mattgardner70/best-ball-balancer/images/driver_wall.png

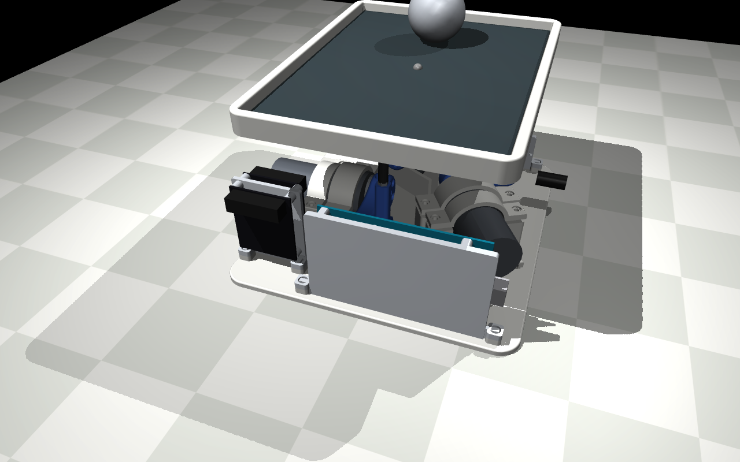
images/driver_wall.png
