mattgardner70/best-ball-balancer/images/hero.png

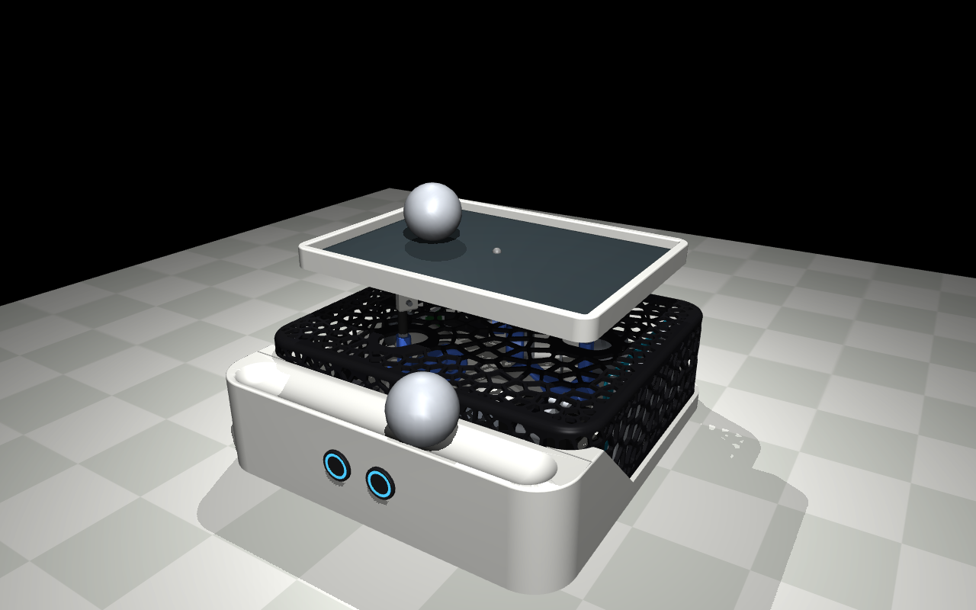
images/hero.png
