mattgardner70/best-ball-balancer/images/hero_liner.png

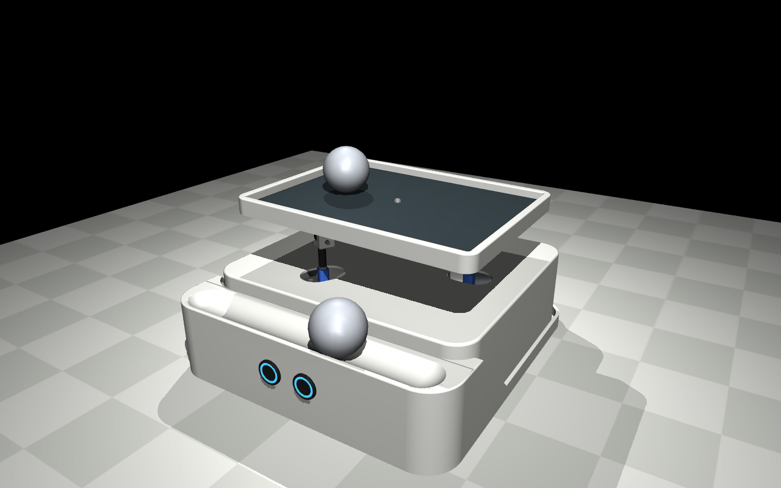
images/hero_liner.png
