mattgardner70/best-ball-balancer/BOM/BOM.md

# Bill of materials

About **$306** in parts at the listed prices, motors and motor drivers included. Links are the listings used for this build; equivalent parts work. **Price ea** is per item, or per pack where you buy a pack; **Total** is what you pay for that line.

## Motion

| Part | Qty used | Buy | Price ea | Total | Where |
|---|---|---|---|---|---|
| GA37-520 (JGB37-520) 12 V gearmotor with hall encoder, 333 rpm | 3 | 3 | $14.40 | $43.20 | [Sileduove B0H4TS383B](https://www.amazon.com/dp/B0H4TS383B) |
| 6 mm rigid flange coupling, 22 mm flange, 4-hole | 3 | 1 pack of 4 | $6.98 | $6.98 | [Amazon B08334N261](https://www.amazon.com/dp/B08334N261) |
| Shoulder bolt, 4 × 10 mm shoulder, M3 × 6 thread (elbow pin) | 3 | 1 pack of 12 | $7.97 | $7.97 | [uxcell B0DP71MPP7](https://www.amazon.com/dp/B0DP71MPP7) |
| Flanged bronze bushing, 4 mm bore × 8 mm OD (elbow) | 3 | 1 pack of 6 | $5.99 | $5.99 | [HARFINGTON B0CGDT9YYW](https://www.amazon.com/dp/B0CGDT9YYW) |
| M3 tie-rod end, ball head (plate joints) | 3 | 1 pack of 10 | $14.09 | $14.09 | [uxcell B07QPXWDCR](https://www.amazon.com/dp/B07QPXWDCR) |
| 1.5" chrome steel ball, G25 | 2 | 1 pack of 2 | $12.95 | $12.95 | [BC Precision B007B2A4ZQ](https://www.amazon.com/dp/B007B2A4ZQ) |

## Electronics

| Part | Qty used | Buy | Price ea | Total | Where |
|---|---|---|---|---|---|
| Heatsinks, 9 × 9 × 5 mm aluminium, with 3M 8810 thermal tape | 8 | 1 pack of 20 | $6.99 | $6.99 | [Easycargo B079FQ22LK](https://www.amazon.com/dp/B079FQ22LK) |
| Arduino Mega 2560 R3 | 1 | 1 | $22.99 | $22.99 | [ELEGOO B01H4ZDYCE](https://www.amazon.com/dp/B01H4ZDYCE) |
| Cytron MDD3A dual motor driver, 4–16 V, 3 A/channel | 2 | 2 | $9.30 | $18.60 | [Cytron MDD3A](https://www.cytron.io/p-3amp-4v-16v-dc-motor-driver-2-channels) |
| USB programming cable: USB-A to **left-angle** USB-B, 2 m (the left-angle plug fits in front of the upside-down Mega; the USB-A end comes out of the console) | 1 | 1 | $8.95 | $8.95 | [StarTech USBAB2ML](https://www.amazon.com/dp/B00GOBM6OC) |
| 8.4" 4-wire resistive touch panel | 1 | 1 | $38.88 | $38.88 | [VSDISPLAY B07TZGVY8K](https://www.amazon.com/dp/B07TZGVY8K) |
| Pololu #2813 pushbutton power switch (soft power) | 1 | 1 | $8.95 | $8.95 | [pololu.com #2813](https://www.pololu.com/product/2813) |
| 12 V → 5 V buck converter, 3 A, sealed, pre-wired | 1 | 1 | $9.99 | $9.99 | [DROK B07P663XJV](https://www.amazon.com/dp/B07P663XJV) |
| POWER button: 16 mm momentary, 12 V LED ring (red), 1NO1NC | 1 | 1 | $8.99 | $8.99 | [APIELE B07GTJBR59](https://www.amazon.com/dp/B07GTJBR59) |
| MODE button: 16 mm momentary, 12 V LED ring (blue), 1NO1NC | 1 | 1 | $8.99 | $8.99 | [APIELE B07GTJ3VJJ](https://www.amazon.com/dp/B07GTJ3VJJ) |

## Power & wiring

| Part | Qty used | Buy | Price ea | Total | Where |
|---|---|---|---|---|---|
| 12 V 5 A wall adapter, 5.5 × 2.1 mm, centre + | 1 | 1 | $19.99 | $19.99 | [Chanzon B073QTNF9F](https://www.amazon.com/dp/B073QTNF9F) |
| Panel-mount 5.5 × 2.1 barrel jack, pre-wired | 1 | 1 pack of 6 | $8.99 | $8.99 | [DALQUIS B0DMW8178V](https://www.amazon.com/dp/B0DMW8178V) |
| Lever connectors (5-port × 6, 4-port × 3 used) | 8 | 1 assortment | $9.99 | $9.99 | [Amazon B0FRFM8JQC](https://www.amazon.com/dp/B0FRFM8JQC) |
| 20 AWG red/black zip cable | ~3 m | 1 spool | $7.99 | $7.99 | [EvZ B00WKHXHYW](https://www.amazon.com/dp/B00WKHXHYW) |
| Dupont jumper leads, 20 cm (M-F / F-F) | ~30 | 1 pack of 120 | $6.98 | $6.98 | [ELEGOO B01EV70C78](https://www.amazon.com/dp/B01EV70C78) |
| Small zip ties, 2.5 mm | ~20 | 1 pack | — | — | any |
| Super glue (CA) | a few drops | 1 tube | — | — | any (insert into rim) |
| Double-sided foam mounting tape | a few cm | 1 roll | — | — | any (holds the Pololu board on its plate) |

## Fasteners

| Part | Qty used | Buy | Price ea | Total | Where |
|---|---|---|---|---|---|
| M3 × 5.7 heat-set inserts | 38 | 1 pack of 100 | $9.99 | $9.99 | [ruthex B08BCRZZS3](https://www.amazon.com/dp/B08BCRZZS3) |
| M3 socket-head screw kit with nuts | see below | 1 kit | $9.99 | $9.99 | [Fgruh B0FG2BRXL3](https://www.amazon.com/dp/B0FG2BRXL3) |
| M3 × 16 grub screws (rod studs) | 3 | 1 pack of 50 | $7.89 | $7.89 | [uxcell B01AXVSM6O](https://www.amazon.com/dp/B01AXVSM6O) |

### Which screw goes where

| Fastener | Qty | Where | Step |
|---|---|---|---|
| M3 × 12 | 12 | Motor straps into the saddle inserts (2 per strap) | Mount the motors |
| M3 × 12 | 12 | Flange couplings onto the arms (4 per arm) | Build the legs |
| Coupling set screw | 3 | Coupling onto the motor's D-shaft, on the flat (comes with the coupling) | Build the legs |
| Shoulder bolt | 3 | Through the rod's bushing into the arm's elbow insert | Build the legs |
| M3 × 16 grub screw + M3 nut | 3 + 3 | Into each rod's top insert, nut locked against the rod | Build the legs |
| M3 × 6 | 4 | Arduino Mega onto its holder's standoffs (its two top-edge holes aren't used) | Mount the electronics |
| M3 × 6 | 4 | MDD3As onto the driver holder (2 each, top holes, into heat-set inserts) | Mount the electronics |
| M3 × 8 | 12 | Holders onto the base plate pads: Mega 6, drivers 4, switch 2 | Mount the electronics |
| Tie-rod end ball screw + nut | 3 | Through each plate nub into the ball joint (comes with the tie-rod ends) | Close it up |

**Heat-set inserts (38):** motor saddles 12, holder pads on the base plate 12, Mega holder standoffs 4, driver holder posts 4, rod tops 3, arm elbows 3.

## Printed parts

About **650 g** of PLA and about **30 hours** on a Bambu Lab P1S (every part fits its 256 mm bed). PETG is better for the arms and rods.

| Part | Qty | Colour | File | Notes |
|---|---|---|---|---|
| base_plate | 1 | white | [`base_plate.stl`](../stl/base_plate.stl) | The chassis: motor saddles, insert pads for the board holders, buck tray, tie loops, and a raised number under each motor. |
| mega_mount | 1 | white | [`mega_mount.stl`](../stl/mega_mount.stl) | Upright wall for the Arduino Mega, six tabs. Print flat on its back, standoffs up. |
| driver_mount | 1 | white | [`driver_mount.stl`](../stl/driver_mount.stl) | Wall carrying both MDD3As back to back, four tabs. Print standing up. |
| switch_mount | 1 | white | [`switch_mount.stl`](../stl/switch_mount.stl) | Small plate for the Pololu switch (foam tape + zip tie), two tabs. Print flat on its back. |
| strap_motor | 3 | white | [`strap_motor.stl`](../stl/strap_motor.stl) | Clamps the motor body. Flattened arch that springs about 2.5 mm as the screws tighten. |
| strap_gearbox | 3 | white | [`strap_gearbox.stl`](../stl/strap_gearbox.stl) | Clamps the gearbox. Same preloaded arch. |
| arm | 3 | PETG | [`arm.stl`](../stl/arm.stl) | Holds the flange coupling; M3 insert in the elbow. |
| rod | 3 | PETG | [`rod.stl`](../stl/rod.stl) | Elbow eye with a pressed bronze bushing; M3 insert on top for the stud. |
| plate_insert | 1 | white | [`plate_insert.stl`](../stl/plate_insert.stl) | Solid plate the glass sits on, with three nubs underneath for the ball joints and two clips to tuck the panel's tail. Print flat, nubs up. |
| plate_rim | 1 | white | [`plate_rim.stl`](../stl/plate_rim.stl) | Outer wall and 0.25" lip; the insert slots in onto its step with a little super glue. Print flat. |
| frame | 1 | white | [`frame.stl`](../stl/frame.stl) | Rim, console with the two buttons, power-jack tab, a hole for the USB cable and a dish for the spare ball. |
| usb_sabot | 1 (two halves) | white | [`usb_sabot.stl`](../stl/usb_sabot.stl) | Clamps the USB cable in the frame's hole. Set `USB_CABLE_OD` in `CAD/enclosure.py` to your cable first (the STL is for 4.5 mm). |
| lattice_shell_v2 | 1 | black | [`lattice_shell_v2.stl`](../stl/lattice_shell_v2.stl) | Voronoi shell over the mechanism. Prints top face down **without supports**: every wall opening has a pointed ceiling, never flatter than 60° from vertical. ([v1](../stl/lattice_shell_v1.stl) is the original free-form version, which needs supports.) |
| liner | 1 | white | [`liner.stl`](../stl/liner.stl) | Optional solid inner shell: hides the mechanism and damps sound. |

## Tools

Soldering iron (about 10 joints on the power switch), heat-set insert tip, multimeter, hex keys, a 5.5 mm wrench, flush cutters, 3D printer.
