mattgardner70/best-ball-balancer/code/sim/meshes/usb_sabot.stl

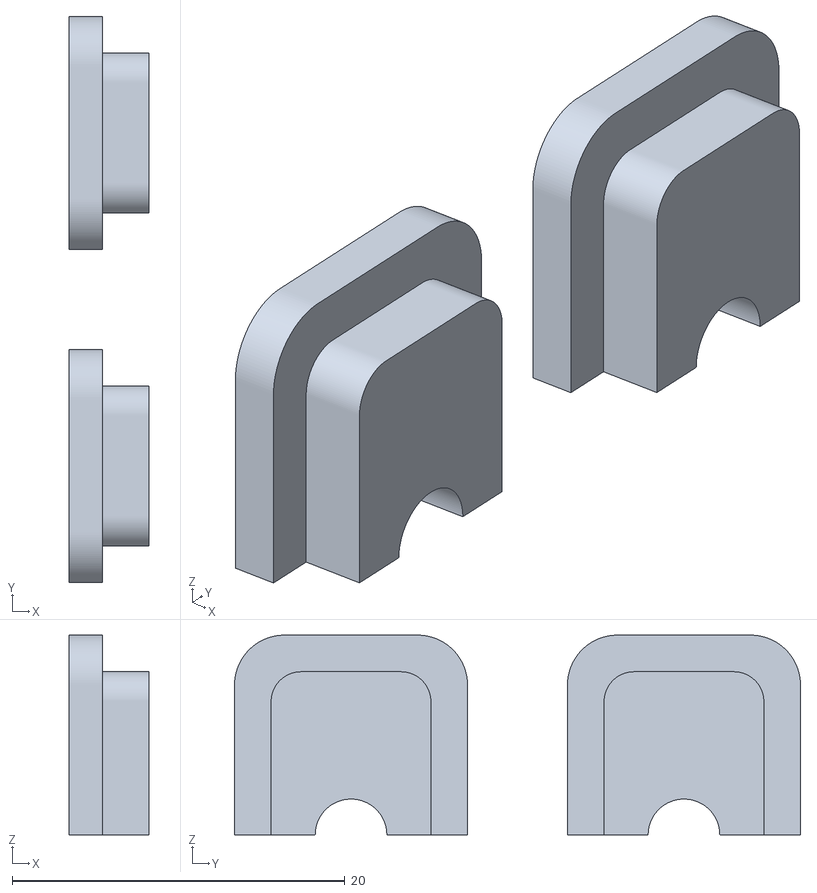
[picture p8: CAD file, 2026-11-04]
code/sim/meshes/usb_sabot.stl
4.80 x 34.0 x 12.0
