mattgardner70/best-ball-balancer/code/sim/meshes/frame.stl

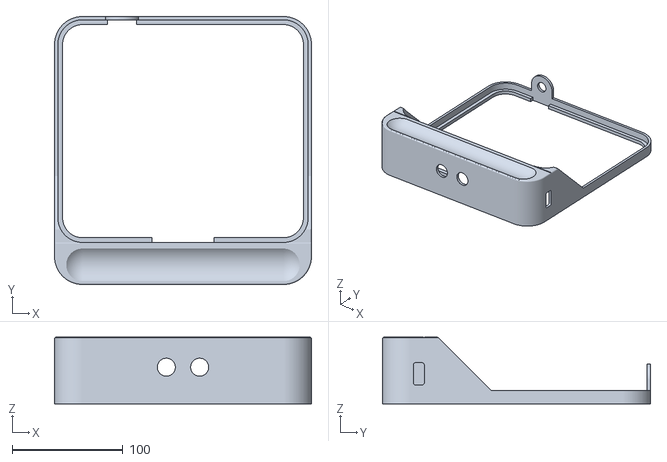
[picture p9: CAD file, 2026-11-04]
code/sim/meshes/frame.stl
231.6 x 241.5 x 60.0
