mattgardner70/best-ball-balancer/code/sim/meshes/mega_mount.stl

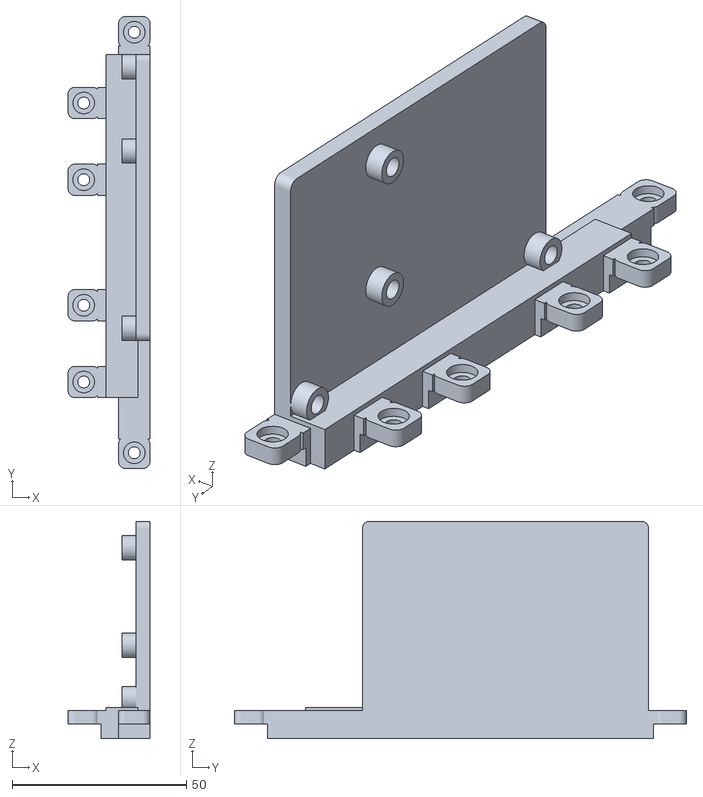
[picture p10: CAD file, 2026-11-04]
code/sim/meshes/mega_mount.stl
23.5 x 129.6 x 62.3
