mattgardner70/best-ball-balancer/code/sim/meshes/plate_insert.stl

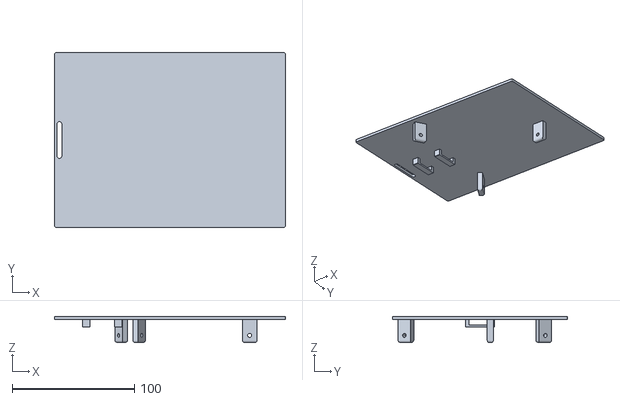
[picture p11: CAD file, 2026-11-04]
code/sim/meshes/plate_insert.stl
188.6 x 142.6 x 21.6
