mattgardner70/best-ball-balancer/code/sim/meshes/driver_mount.stl

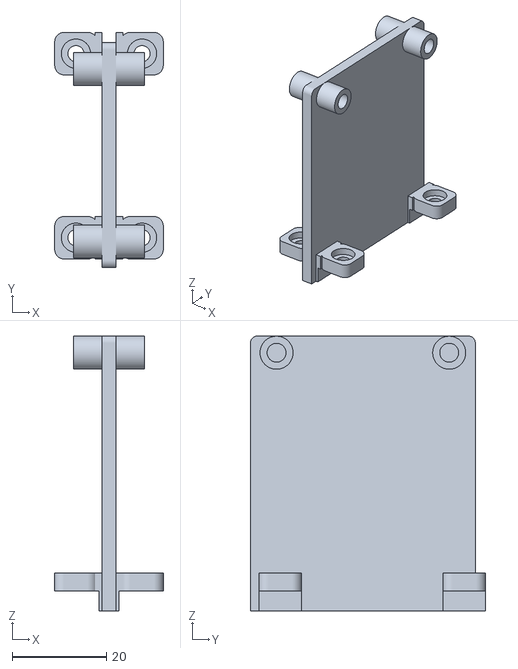
[picture p12: CAD file, 2026-10-24]
code/sim/meshes/driver_mount.stl
23.0 x 49.8 x 58.3
