mattgardner70/best-ball-balancer/stl/switch_mount.stl

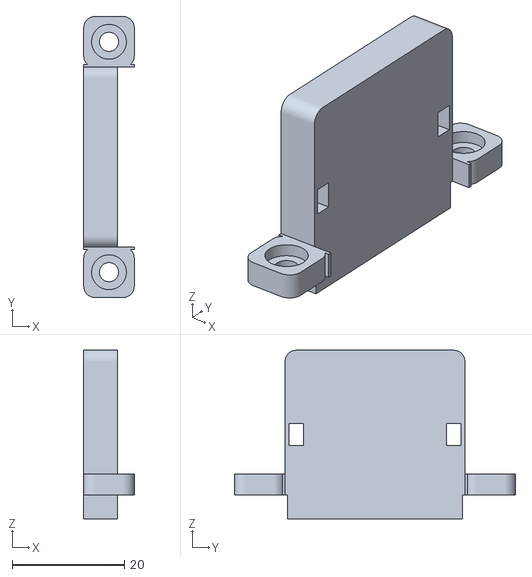
[picture p13: CAD file, 2026-10-24]
stl/switch_mount.stl
9.00 x 50.0 x 30.0
