mattgardner70/best-ball-balancer/code/sim/meshes/arm.stl

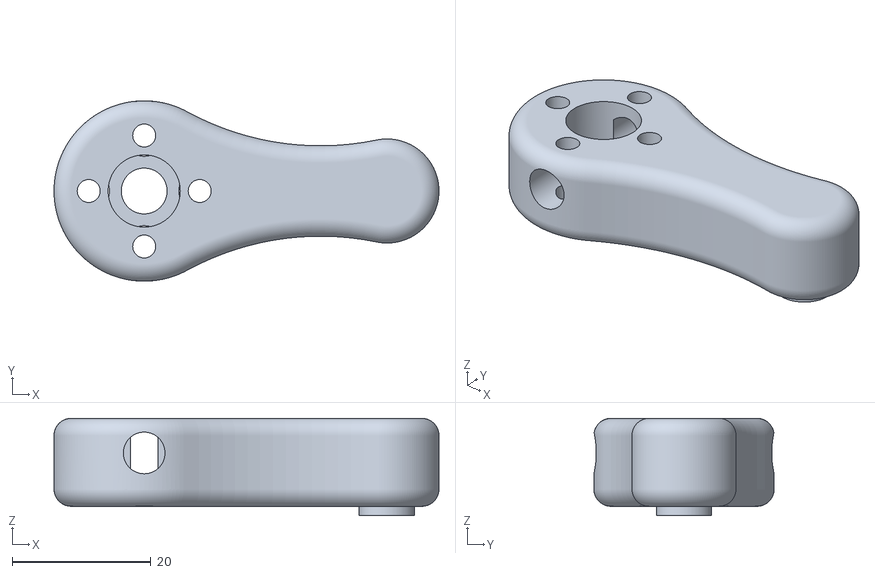
[picture p14: CAD file, 2026-10-23]
code/sim/meshes/arm.stl
55.5 x 26.0 x 14.0
