mattgardner70/best-ball-balancer/code/sim/meshes/hub.stl

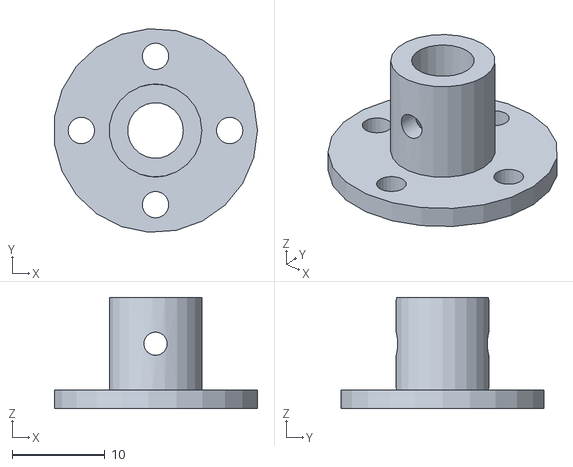
[picture p15: CAD file, 2026-10-23]
code/sim/meshes/hub.stl
21.9 x 21.9 x 12.0
