mattgardner70/best-ball-balancer/stl/lattice_shell_v2.stl

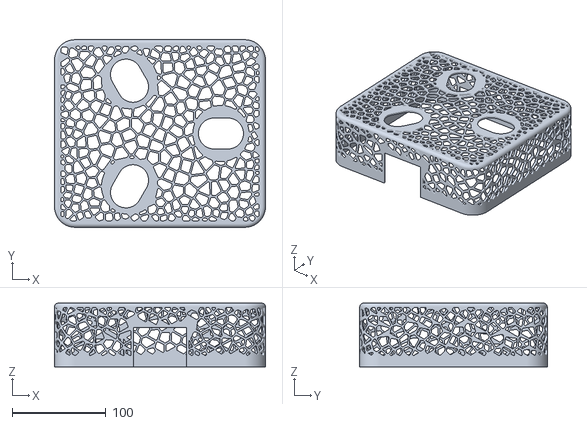
[picture p16: CAD file, 2026-10-22]
stl/lattice_shell_v2.stl
225.0 x 200.0 x 68.0
