mattgardner70/best-ball-balancer/stl/liner.stl

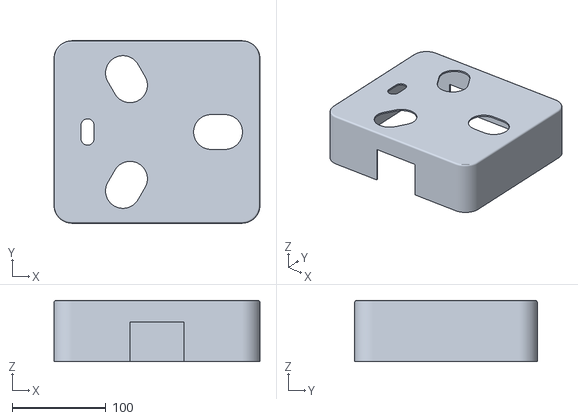
[picture p17: CAD file, 2026-10-22]
stl/liner.stl
219.4 x 194.4 x 65.2
