mattgardner70/best-ball-balancer/code/sim/meshes/plate_rim.stl

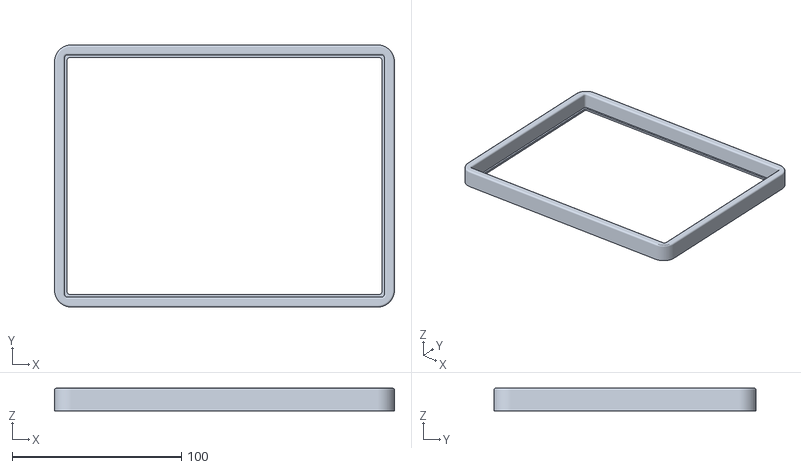
[picture p18: CAD file, 2026-10-20]
code/sim/meshes/plate_rim.stl
201.0 x 155.0 x 13.4
