mattgardner70/best-ball-balancer/code/sim/meshes/base_plate.stl

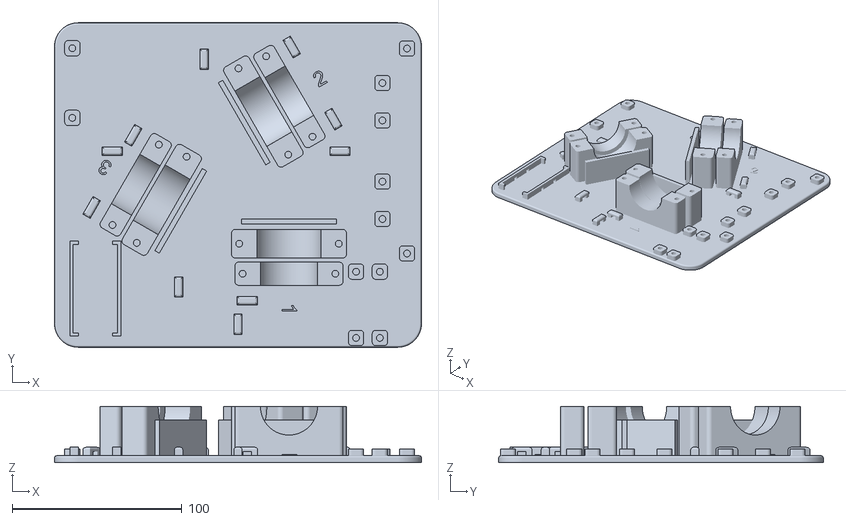
[picture p19: CAD file, 2026-10-20]
code/sim/meshes/base_plate.stl
216.0 x 191.0 x 33.0
