mattgardner70/best-ball-balancer/stl/strap_motor.stl

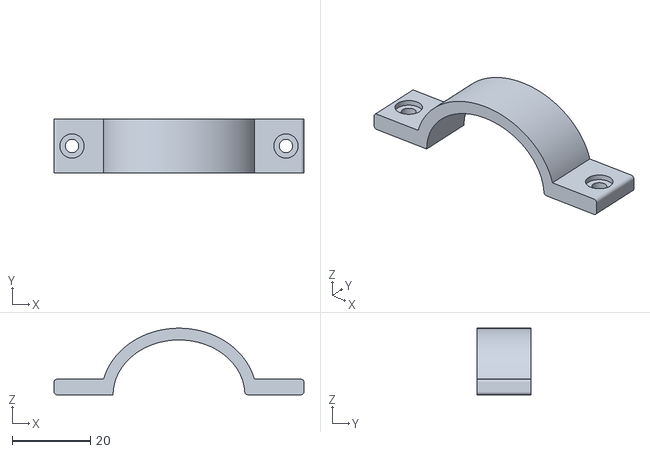
[picture p20: CAD file, 2026-10-20]
stl/strap_motor.stl
63.8 x 13.7 x 17.0
