mattgardner70/best-ball-balancer/stl/strap_gearbox.stl

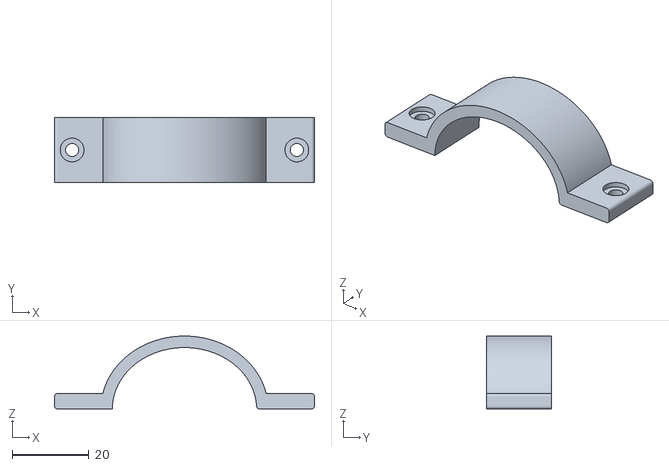
[picture p21: CAD file, 2026-10-20]
stl/strap_gearbox.stl
67.8 x 17.0 x 19.0
