mattgardner70/best-ball-balancer/code/sim/meshes/ball_socket.stl

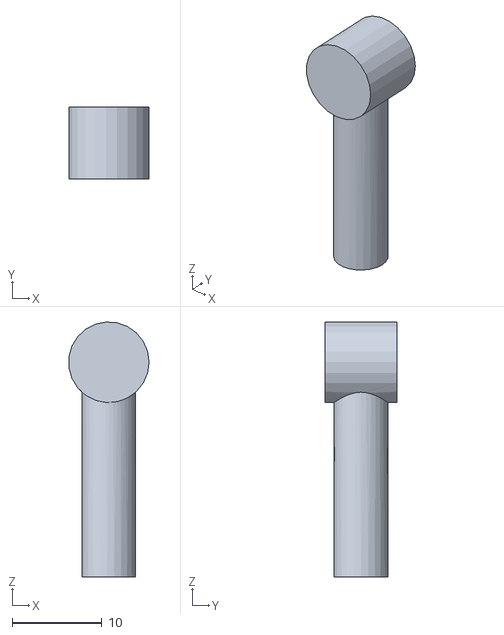
[picture p22: CAD file, 2026-10-20]
code/sim/meshes/ball_socket.stl
8.96 x 8.00 x 28.5
