mattgardner70/best-ball-balancer/stl/rod.stl

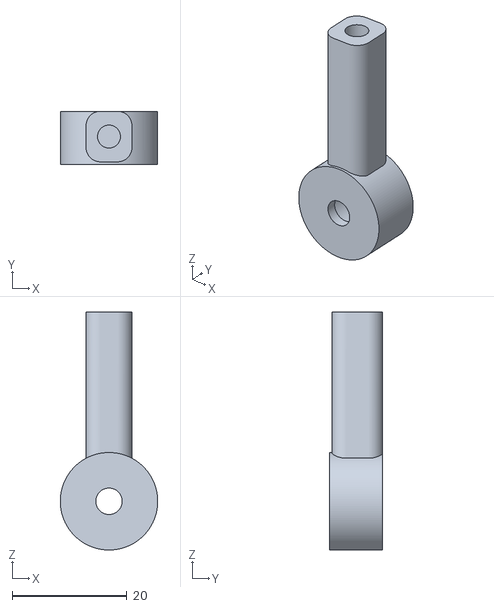
[picture p23: CAD file, 2026-10-20]
stl/rod.stl
17.0 x 9.30 x 41.5
