mattgardner70/best-ball-balancer/code/sim/meshes/button_ring.stl

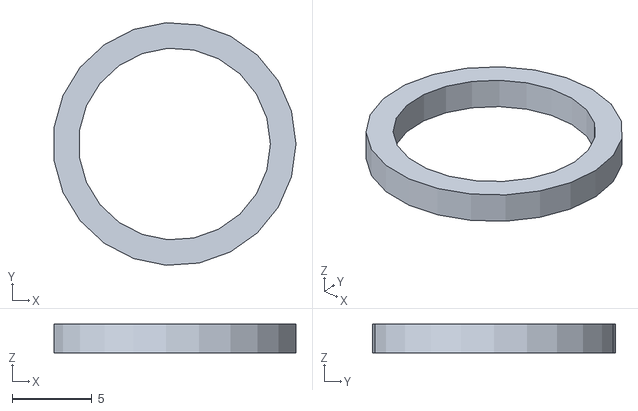
[picture p24: CAD file, 2026-10-20]
code/sim/meshes/button_ring.stl
15.1 x 15.2 x 1.80
