mattgardner70/best-ball-balancer/code/sim/meshes/stud_m3.stl

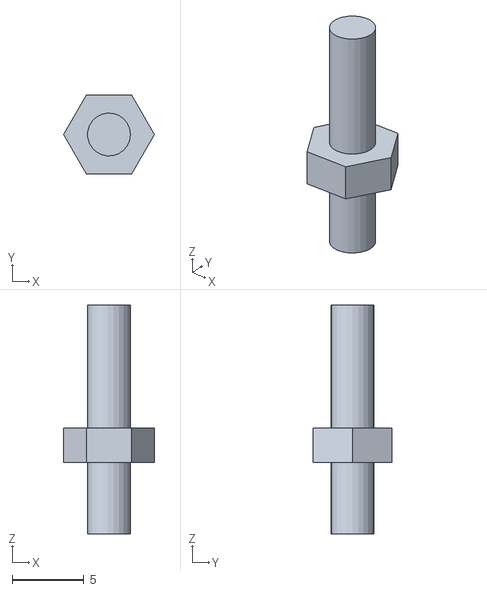
[picture p25: CAD file, 2026-10-20]
code/sim/meshes/stud_m3.stl
6.35 x 5.50 x 16.0
