mattgardner70/best-ball-balancer/code/sim/meshes/bushing.stl

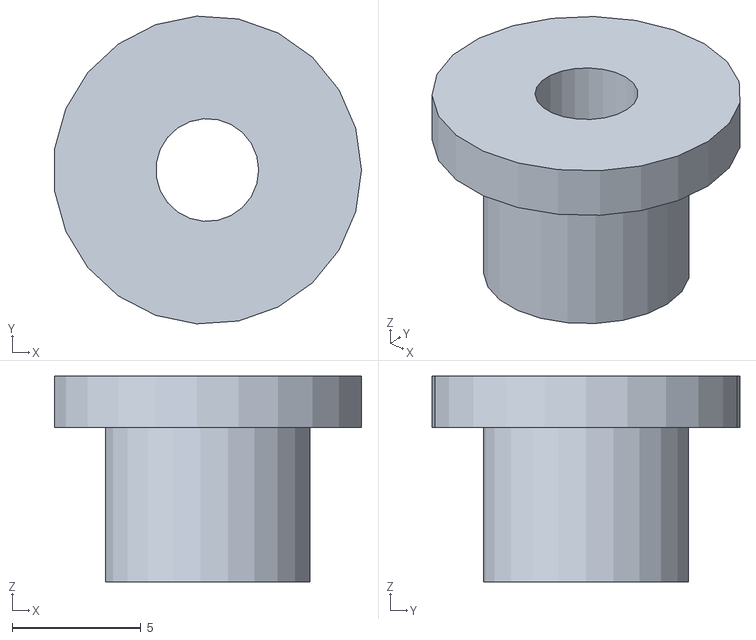
[picture p26: CAD file, 2026-10-20]
code/sim/meshes/bushing.stl
11.9 x 12.0 x 8.00
