mattgardner70/best-ball-balancer/code/sim/meshes/button.stl

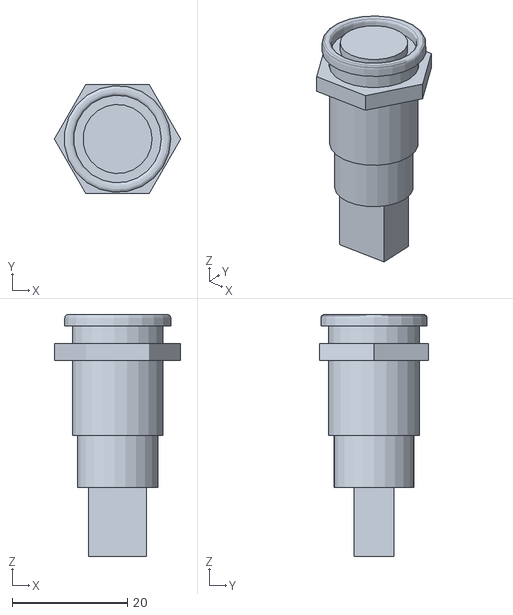
[picture p27: CAD file, 2026-10-20]
code/sim/meshes/button.stl
21.9 x 19.0 x 42.0
