mattgardner70/best-ball-balancer/code/sim/meshes/ga37.stl

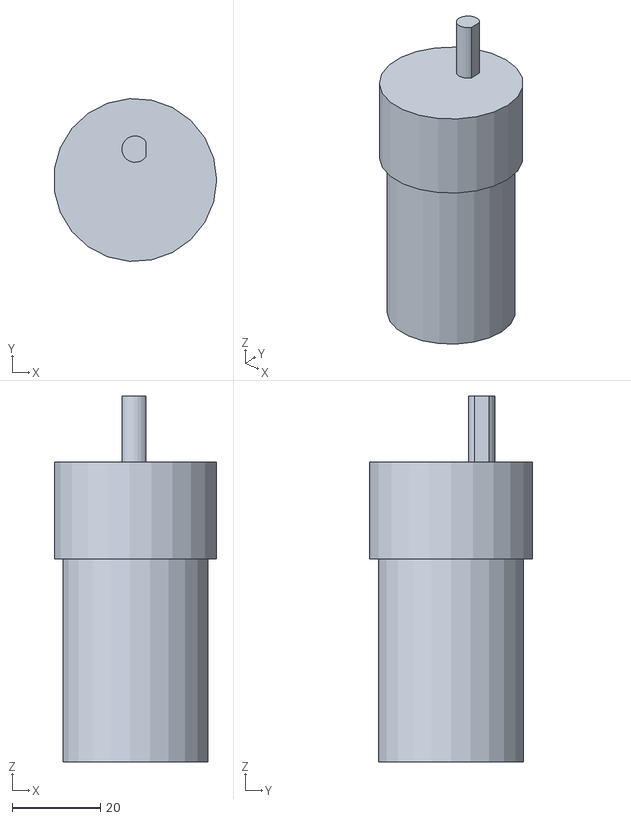
[picture p28: CAD file, 2026-10-20]
code/sim/meshes/ga37.stl
36.8 x 36.9 x 83.0
