mattgardner70/best-ball-balancer/code/sim/meshes/ball_stud.stl

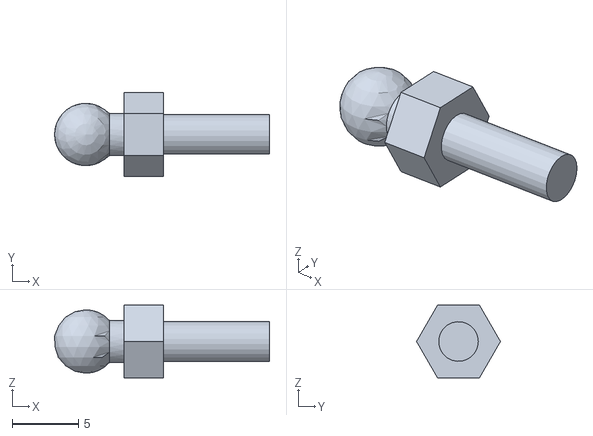
[picture p29: CAD file, 2026-10-20]
code/sim/meshes/ball_stud.stl
16.3 x 6.35 x 5.50
