mattgardner70/best-ball-balancer/(list of files, cad)

Other CAD files:
code/sim/meshes/shoulder_bolt.stl
stl/lattice_shell_v1.stl
