mattgardner70/best-ball-balancer/wiring/README.md

# Wiring

Everything you need to wire the balancer: 56 connections between the power jack, the soft power switch, the Wago lever connectors, the Arduino Mega, two motor drivers, three motors, the touch panel and the two buttons.

https://github.com/user-attachments/assets/843bd77f-8e50-462b-997f-23ea67aadc6e

> **The video predates two changes; follow the [PDF](wiring.pdf) for these 8 wires:** motor 2's power leads go to driver #2's M1 terminals and motor 3's to driver #1's M2 terminals (swapped from the video), and the touch-panel tail runs pin 1 (Y−) to A0 through pin 4 (X+) to A3 (reversed from the video). The PDF and the firmware match.

**The wiring video** (about 4¾ min, top-down). Every connection is drawn in order, 5 seconds each, with both ends named and the wire type below. Earlier wires stay faint so the current one stands out. Pause it, make that connection, play on.

The Wago buses are colour-coded in the video: **dark red** = +12 V, **orange** = +5 V, **black** = ground. The wires follow the same colours: 12 V dark red, 5 V orange, ground dark grey, encoders blue and purple, signals yellow and white.

## The files

| File | What it is |
|---|---|
| [`wiring.pdf`](wiring.pdf) | **Print this.** The diagram: one page each for power (every Wago port), motors and encoders, and the touch panel, buttons and soft power, then a wire list by part. |

The video is drawn from the same connection list as the PDF ([`code/tools/wiring_list.py`](../code/tools/wiring_list.py)); to re-render it: `cd code && uv run python tools/wiring_anim.py`.

## How it's wired, in brief

- **Power:** 12 V adapter → panel jack → Pololu soft power switch → the +12 V Wagos. A buck converter makes 5 V for the motor encoders. The Mega takes 12 V on VIN and makes its own 5 V.
- **Ground:** every ground goes to the four linked ground Wagos.
- **Motors:** each motor's two power leads go to a driver terminal (motor 1: driver #1 M1, motor 2: driver #2 M1, motor 3: driver #1 M2); its encoder's A and B go to interrupt pins on the Mega (motor 1 D2/D19, motor 2 D3/D20, motor 3 D18/D21).
- **Drivers:** two PWM pins per motor from the Mega (motor 1 D6/D7, motor 2 D45/D46, motor 3 D8/D44), at 20 kHz so they're silent.
- **Touch panel:** its four tail wires go straight to A0–A3, tail pin 1 (Y−) on A0 through pin 4 (X+) on A3.
- **Buttons:** POWER's NO switches the Pololu on (to its A pin; C to ground); its NC goes to D31, so a press while running makes the Mega lower the arms and then switch the power off through D32 → the Pololu's OFF pin. MODE goes to D30 and steps the pattern.

## Before you power it on

- Connect the motors last. Power up once without them and check with a meter: **12 V** on the +12 V Wagos and **5.0 V** on the +5 V Wago.
- **Never** connect 12 V to a driver's or the Mega's 5 V pin.
- Leave both MDD3As' 5V pins unconnected: they're outputs from the boards' own regulators.
- Motor connector pins, left to right: 1 M+ (yellow), 2 GND (black), 3 A (blue), 4 B (purple), 5 5V (red), 6 M− (white).
- Button harness colours vary by batch: check LED+, LED−, C, NO and NC with a meter before connecting.
