mattgardner70/best-ball-balancer/assembly.md

# Assembly guide

Eight stages, from a pile of parts to a balancing ball. Each one has an animation showing the parts going together in order. Keep the [bill of materials](BOM/BOM.md) and the [wiring diagram](wiring/wiring.pdf) open alongside.

| Stage | What | Time |
|---|---|---|
| [1](#1-print-the-parts) | Print the parts | ~30 h (unattended) |
| [2](#2-set-the-heat-set-inserts) | Set the heat-set inserts | 20 min |
| [3](#3-mount-the-motors) | Mount the motors | 30 min |
| [4](#4-build-the-legs) | Build the legs | 45 min |
| [5](#5-mount-the-electronics) | Mount the electronics | 30 min |
| [6](#6-wire-it) | Wire it | ~5 h |
| [7](#7-close-it-up) | Close it up: frame, shell, plate | 30 min |
| [8](#8-bring-it-to-life) | Flash, calibrate, tune | 1–5 h (integration hell) |

---

## 1. Print the parts

All files are in [`stl/`](stl/). PLA is fine everywhere; PETG is better for the arms and rods.

| Part | Qty | Orientation |
|---|---|---|
| [`base_plate`](stl/base_plate.stl) | 1 | Flat, as modelled |
| [`mega_mount`](stl/mega_mount.stl) | 1 | Flat on its back, standoffs up |
| [`driver_mount`](stl/driver_mount.stl) | 1 | Standing up, on its tabs |
| [`switch_mount`](stl/switch_mount.stl) | 1 | Flat on its back |
| [`strap_motor`](stl/strap_motor.stl), [`strap_gearbox`](stl/strap_gearbox.stl) | 3 each | Arch up |
| [`arm`](stl/arm.stl) | 3 | Flat |
| [`rod`](stl/rod.stl) | 3 | Standing up |
| [`plate_insert`](stl/plate_insert.stl) | 1 | Flat, nubs up |
| [`plate_rim`](stl/plate_rim.stl) | 1 | Flat |
| [`frame`](stl/frame.stl) | 1 | Open side down, supports under the console top |
| [`usb_sabot`](stl/usb_sabot.stl) | 1 (two halves) | Split face down. Measure your USB cable's thickness first and set `USB_CABLE_OD` in [`CAD/enclosure.py`](CAD/enclosure.py) (the STL is for 4.5 mm) |
| [`lattice_shell_v2`](stl/lattice_shell_v2.stl) | 1 | Top face down, no supports needed ([v1](stl/lattice_shell_v1.stl) is the original, which needs supports) |
| [`liner`](stl/liner.stl) (optional) | 1 | Top face down |

## 2. Set the heat-set inserts

Press **38 M3 inserts** with a soldering iron and insert tip, flush with the surface:

- **Base plate:** 12 in the motor saddles (two beside each strap) and 12 in the raised pads the board holders screw onto.
- **Mega holder:** 4 in its standoffs.
- **Driver holder:** 4 in its posts (2 on each face).
- **Arms:** 1 in each elbow tip.
- **Rods:** 1 in each top face.

## 3. Mount the motors

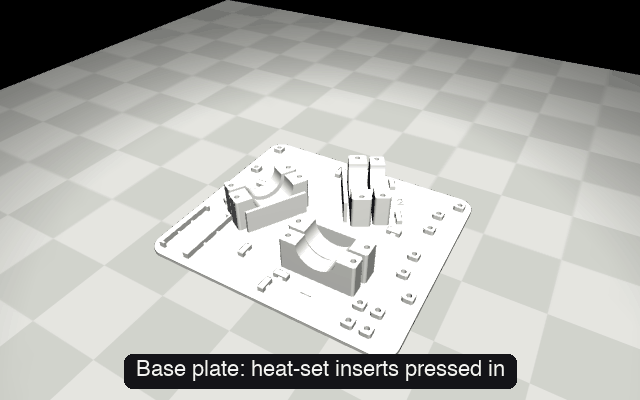
[picture p30: images/assembly/1_base_motors.gif]
Motors into their saddles, then the straps


1. Lay each motor in its two saddles, gearbox face against the lip, so the shaft points along its leg. Each motor's number (**1**, **2**, **3**) is moulded into the floor under it.
2. Fit the **gearbox strap** and the **motor strap**, each with two **M3 × 12** screws.
3. Tighten until the strap's ears touch the saddle. The straps are deliberately flat: when they're snug on the motor, the ears still sit about 2.5 mm high, so tightening springs them down and clamps the motor firmly. A motor that can shift in its saddle makes the plate imprecise. The screws sit far enough from the arch to get a wrench on them.

## 4. Build the legs

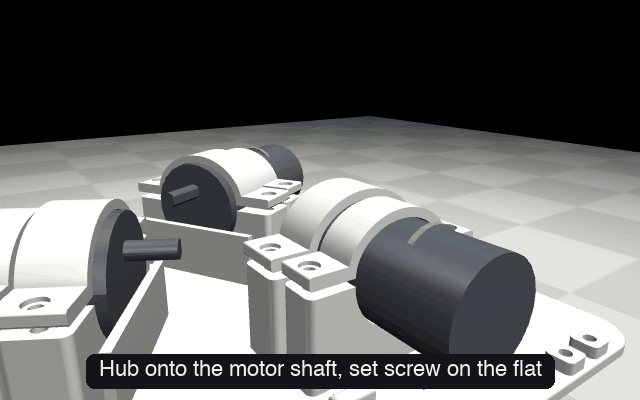
[picture p31: images/assembly/2_legs.gif]
Hub, arm, bushing, shoulder bolt, rod end


Each leg goes together on its motor, in this order:

1. **Hub onto the shaft.** Slide the flange coupling onto the motor's D-shaft and tighten **both** set screws, one onto the flat. Do it now: once the arm is on, each set screw sits behind one of the flange bolts (take that bolt out to reach it later).
2. **Arm onto the hub.** Fit the arm over the coupling's flange, with the two set screws facing the arm's side access holes, and bolt it on with four **M3 × 12** screws.
3. **Bushing into the rod.** Heat-press the flanged bronze bushing into the rod's elbow eye, from the side the bolt head will be on.
4. **Rod onto the arm.** Pass a **shoulder bolt** through the bushing and thread it into the arm's elbow insert. The rod should swing freely with no play.
5. **Rod end.** Thread an **M3 × 16 grub screw** into the rod's top insert and lock it with an **M3 nut**, then screw the **tie-rod end** socket onto it.

> **Tip:** draw a line across the shaft, coupling and arm with a marker. If an arm ever slips on its shaft, you'll see it immediately.

## 5. Mount the electronics

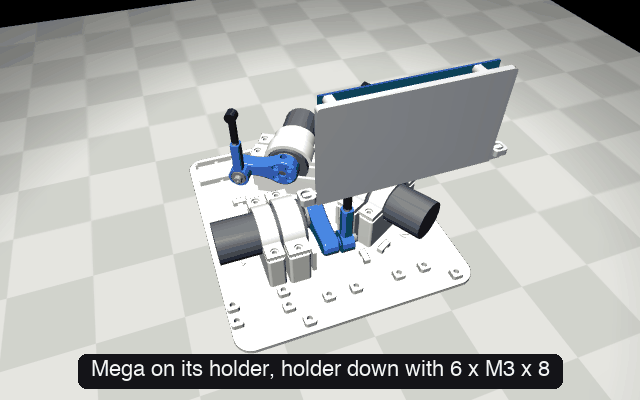
[picture p32: images/assembly/3_electronics.gif]
Each board on its holder, each holder onto the base


Every board has its own printed holder. **Screw each holder down first** with **M3 × 8** screws into the pads on the base plate (some of the screws sit under where the board goes), then mount its board.

1. **Arduino Mega:** it mounts **upside down** on its holder, components facing the centre, USB end toward the front, clear of the moving arms. Screw the holder down first (the board's end sits over one of its pads), then the board with four **M3 × 6** screws into the holder's inserts (two of them have little straight room: use a short hex key). Plug in the **left-angle USB-B cable** (StarTech USBAB2ML) now: there isn't room for a straight plug.
2. **Motor drivers:** stick **4 heatsinks** on each MDD3A, one on each of the four small 8-pin chips beside the terminal blocks (the tape comes on them). Then screw the boards back to back onto the driver holder, one on each face, with two **M3 × 6** screws each, through its two top holes into the inserts: terminal blocks up, input header down.
3. **Power switch:** stick the **Pololu** board onto its holder plate with double-sided foam tape, terminals facing out, and loop a zip tie through the two slots and across the board. It sits by the left wall, facing the centre, close to the power jack.
4. **Buck converter:** drop it into its tray and strap it down with a zip tie through the two slots.

## 6. Wire it

https://github.com/user-attachments/assets/843bd77f-8e50-462b-997f-23ea67aadc6e

The **wiring video** (about 4¾ min, top-down) draws every one of the 56 connections in order, 5 seconds each, naming both ends. Follow along with the [wiring diagram](wiring/wiring.pdf), which has every connection on one page per subsystem and a wire list by part. More in the [wiring guide](wiring/README.md).

- **Power and ground** run through lever connectors, one bus each for +12 V, +5 V and ground.
- **Signals** are Dupont leads straight onto the Mega's pins.
- **Soldering** is only needed on the Pololu power switch (its two terminal blocks and a few pins).

Before connecting the motors, power it once and check with a meter: 12 V on the +12 V bus and 5.0 V on the +5 V bus.

> **Never** connect 12 V to a driver's or the Mega's 5 V pin.

## 7. Close it up

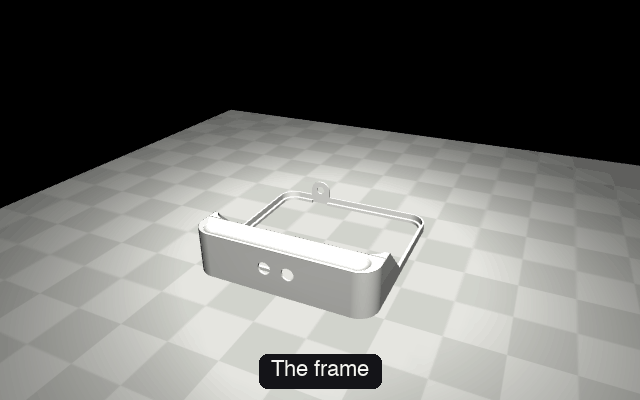
[picture p33: images/assembly/4_enclosure_plate.gif]
Frame, buttons, jack, base, shell, plate, ball


1. **Buttons:** push the two buttons in through the console face (red POWER on the left, blue MODE on the right) and tighten their nuts from behind.
2. **Jack:** fit the barrel jack into the frame's back tab from outside.
3. **USB cable:** before the base goes in, pass the cable's USB-A plug out through the hole in the console's right end, from inside. Clamp the two `usb_sabot` halves round the cable just inside, and slide them out into the hole until the flange meets the wall. The plug stays outside for programming. As the base goes in, run the cable along the front wall and through the front notch.
4. **Base into the frame:** lower the wired base into the frame.
5. **Shell:** lower the liner (optional) and the lattice shell over the mechanism, with the three rods coming up through the slots in the top.
6. **Plate:** slot the insert into the rim (it rests on the rim's step) with a few drops of super glue. Feed the panel's tail down through the slot in the insert, fold it back flat under the two clips, and lay the glass in.
7. **Plate onto the joints:** screw the plate's three nubs onto the ball joints.
8. **Ball:** set the ball on the panel, and the spare in the console dish.

## 8. Bring it to life

### Flash the firmware

See [Quick start](README.md#quick-start). Optional first: the four [bring-up sketches](code/firmware/bringup/) test the encoders, motor directions, touch panel and homing one at a time.

### First power-up

Power on. The balancer will:

1. **Home:** each arm creeps down until it stops against the base, then all three push down together to seat the plate.
2. **Raise:** the arms lift the plate to level.
3. **Balance:** the moment a ball touches the panel, it starts steering the ball (circle mode by default).

### Talk to it

Connect over USB at 115200 baud with the console: it finds the Mega, unlocks the keys and shows the log. Opening the port resets the Mega, so it homes again.

```sh
uv run python code/tools/console.py
uv run python code/tools/viz.py            # optional, in a second terminal: live top-down view
```

Type a setting and a value (`kp 6.5`, `mode square`), `get` to see them all and `save` to keep them, or a single key:

| Type | Does |
|---|---|
| `mode <name>` / `n` | Pattern: centre, circle, figure-8, square, wander (the MODE button steps too) |
| `kp` `ki` `kd` | Ball gains (`v` shows them) |
| `cx` `cy` | Where the plate's centre is, mm |
| `t1` `t2` `t3` | Leg trims, degrees up |
| `?` | Where the ball is |
| `park` / `home` | Arms down slowly, motors off / home and raise again |
| `s` | Stop all motors at once |

Every command: [code/tools/README.md](code/tools/README.md). In the Arduino Serial Monitor instead, set **No line ending**, send `~balancer-hello~` once, then type commands with a leading `:` and a newline (`:kp 6.5`).

### Calibrate

The [tuning guide](tuning.md) has the details.

1. **Panel axes:** rest the ball (by its own weight, not held down) over motor 1 and send `k1`; repeat for `k2` and `k3`.
2. **Level:** put an inclinometer on the plate, pointing at each motor in turn, and raise the low legs with `t1` `t2` `t3` until it reads level.
3. **Centre:** hold the ball at the plate's physical centre, type `?`, and set `cx` `cy` to what it reads.
4. **Gains and paths:** start from the defaults; see the [tuning guide](tuning.md).
5. **`save`.** Settings are kept in the Mega's EEPROM, through power-off and firmware updates.

**Before uploading new firmware, type `park`:** the reset drops the plate, and the ball is heavy enough to damage things nearby.

### When things go wrong

| Symptom | Likely cause |
|---|---|
| An arm runs to full extension | Loose encoder wire: reseat it, then glue it |
| An arm goes the wrong way | Motor leads swapped on the driver (M+ / M−) |
| The plate leans with the ball at centre | Leg trims (`1` `2` `3`), or an arm slipping on its shaft |
| Jitter near the edges | Ball is beyond the panel's active area; keep patterns inside it |
| The ball "isn't seen" | Panel tail wires: A0–A3, see the wiring diagram |
| A motor driver runs hot | Check its heatsinks are on; run without the liner for more airflow |
| "encoder fault" at power-up, nothing moves | The log names the motor and the wire. All six encoder wires low and flooding = no 5 V to the encoders (check the buck converter and the 5 V bus) |
| The POWER button cuts power without parking | Its C contact must go to ground and NO to the Pololu's A pin; NC goes to D31. The log says "armed" once D31 reads right |
| The ball doesn't trace the pattern | Expected: tune the pattern's path ([tuning guide](tuning.md#4-tune-the-paths)) |
