mattgardner70/best-ball-balancer/wiring/wiring.pdf

# Ball balancer wiring

Every connection, generated from the same list as the tables below (docs/wiring.py). Power and

ground run through eight WAGO 221-415 lever connectors: two for +12 V, two for +5 V, four for

ground, each pair or group linked by a short jumper. Signals are Dupont leads. Hover a wire to see its

two ends.

+12 V | +5 V | GND | Wago link | motor + | motor − | encoder A | encoder B | PWM | touch panel | buttons | power-off control

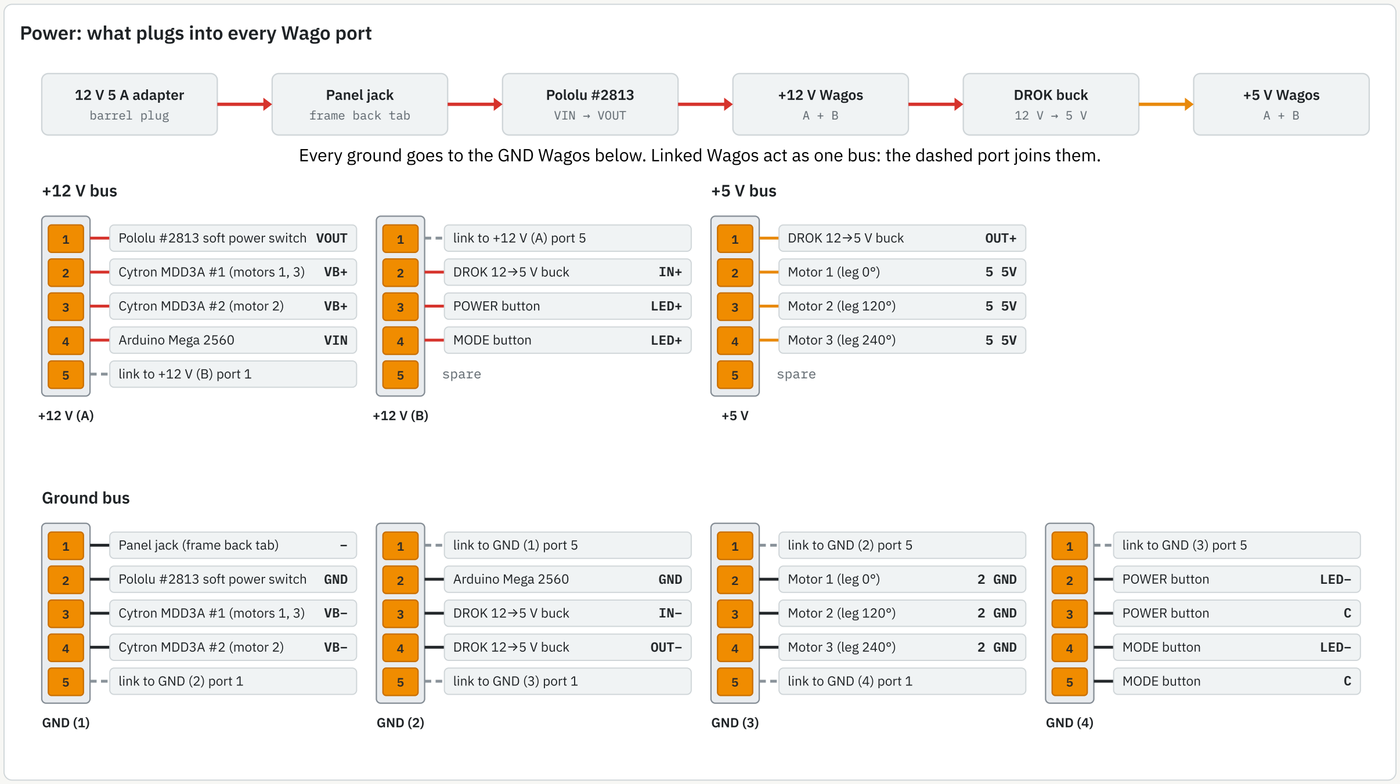
[picture p34: figure]
Power: what plugs into every Wago port; 12 V 5 A adapter barrel plug; Panel jack frame back tab; Pololu #2813 VIN → VOUT; +12 V Wagos A + B; DROK buck 12 V → 5 V; +5 V Wagos A + B; +12 V bus; Pololu #2813 soft power switch VOUT; Cytron MDD3A #1 (motors 1, 3); Cytron MDD3A #2 (motor 2); Arduino Mega 2560; VIN; link to +12 V (B) port 1; link to +12 V (A) port 5; DROK 12→5 V buck; POWER button; LED+; MODE button; spare; +5 V bus; OUT+; Motor 1 (leg 0°); Motor 2 (leg 120°); Motor 3 (leg 240°); Ground bus; GND (1); Panel jack (frame back tab); Pololu #2813 soft power switch; GND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

Every ground goes to the GND Wagos below. Linked Wagos act as one bus: the dashed port joins them.

## Motors: control signals, motor power and encoders

D6

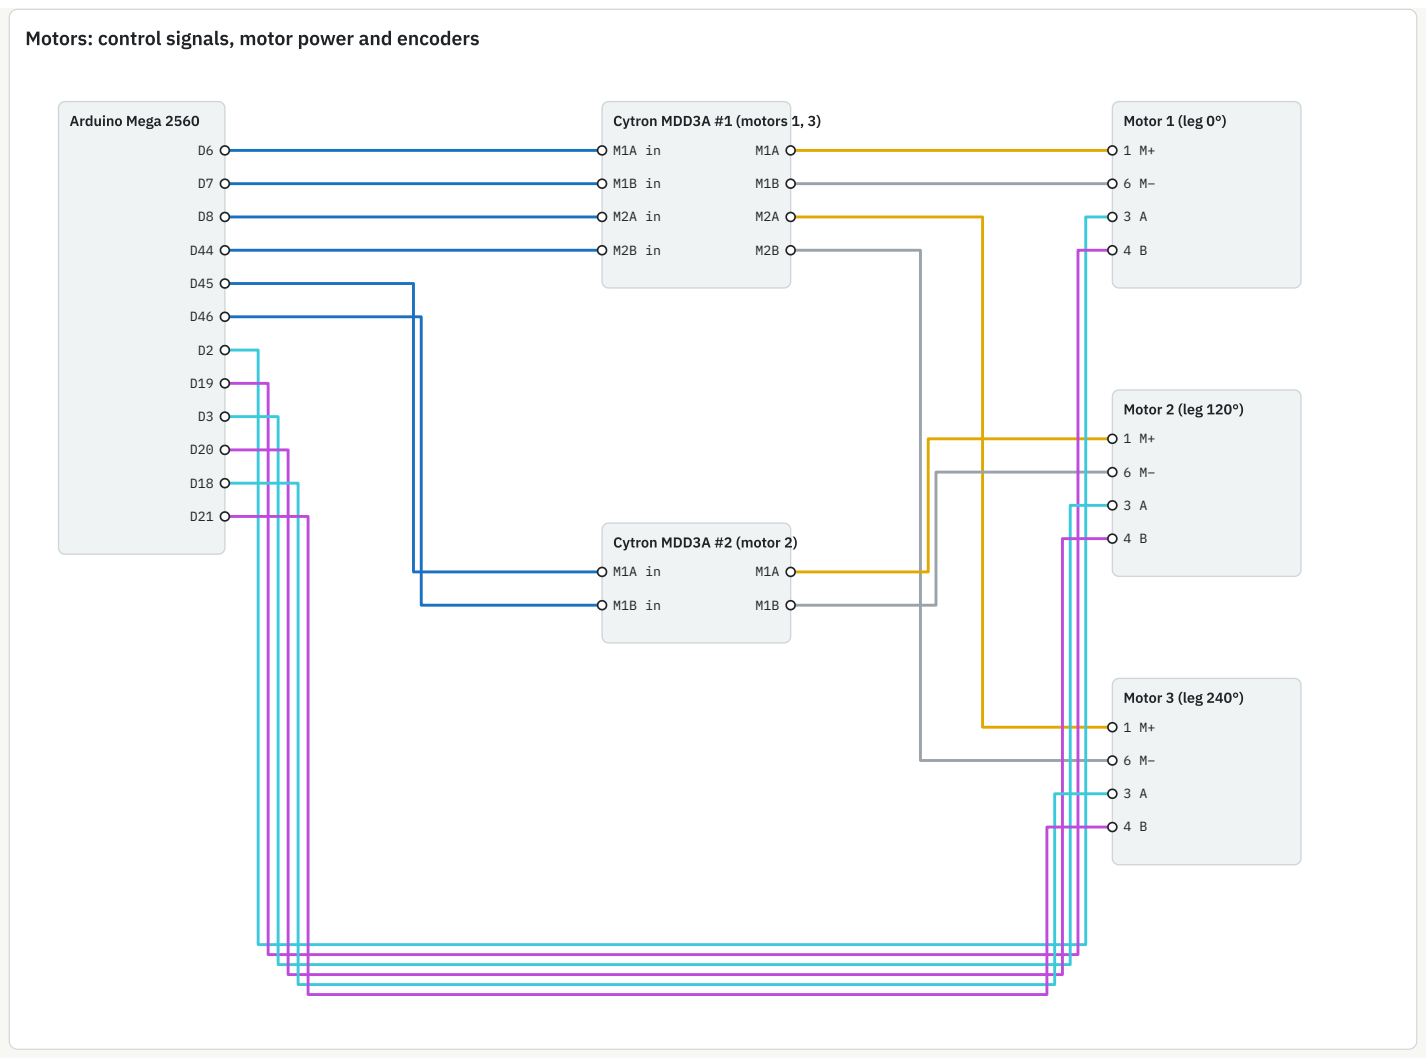
[picture p35: page 2]

## Touch panel, buttons and soft power

## 1 Y−

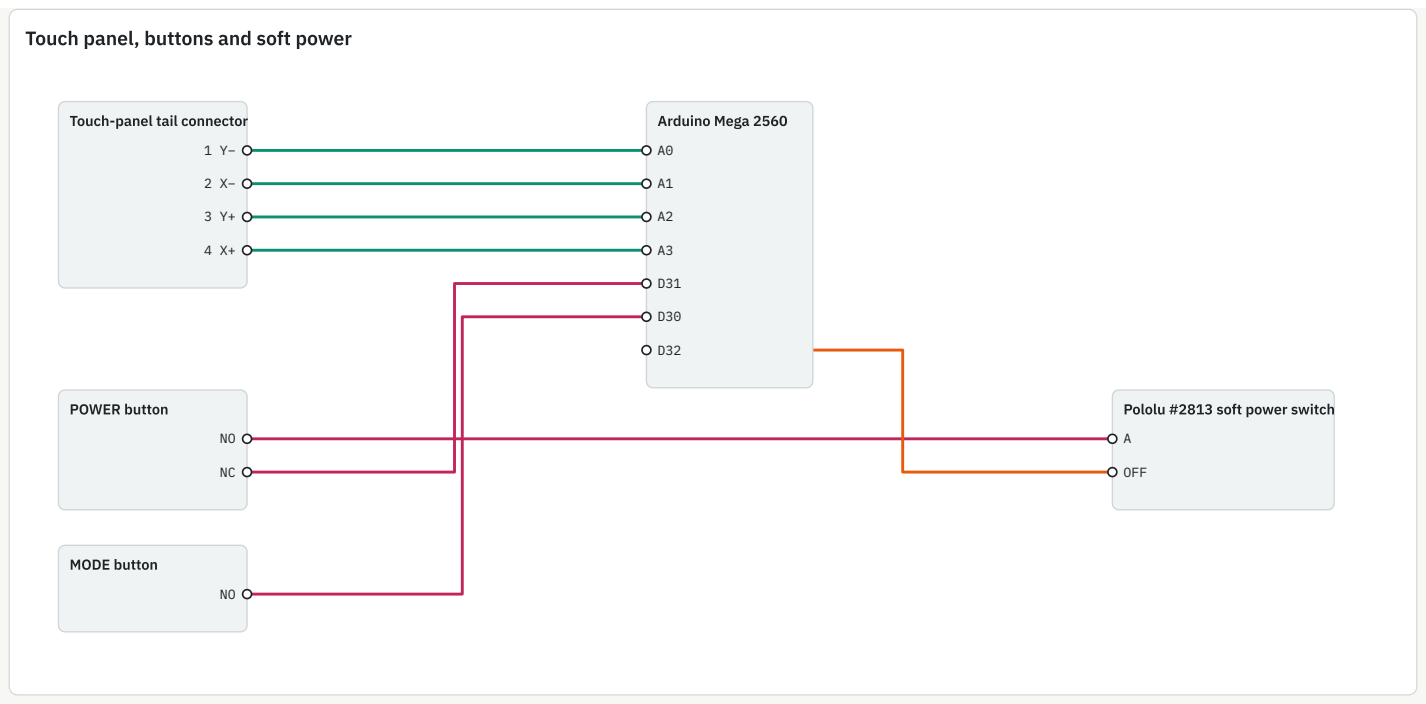
[picture p36: page 3]
POWER button; MODE button; Arduino Mega 2560

Touch-panel tail connector

Pololu #2813 soft power switch
OFF

## Before you power it on

Fit the motors' leads last. First power-up: no motors connected, check 12 V on the +12 V Wagos and 5.0 V on the +5 V Wagos with a meter.

Never connect the buck's 5 V output and the Mega's USB 5 V together; the Mega takes 12 V on VIN only and makes its own 5 V.

Touch-panel tail order (Y−, X−, Y+, X+) is from a similar panel's datasheet: confirm with a meter (about 200–900 Ω across each X pair and each Y pair).

Motor connector pins, left to right: 1 M+, 2 GND, 3 A, 4 B, 5 5V, 6 M−. Port labels give the pin number.

Our motor cable colours: M+ yellow, GND black, A blue, B purple, 5V red, M− white.

Our button harness colours: NO blue, C green, NC yellow, LED+ red, LED− black.

Button harness colours vary by batch: identify LED+, LED−, C, NO and NC with a meter before connecting.

Program the Mega over USB with the shell lifted; the soft switch can stay off while USB powers the Mega's logic.

Second MDD3A's channel 2 is unused. Leave both MDD3As' 5V pins unconnected: they are outputs from the board's own regulator.

## Wire list by part

PIN | GOES TO | WIRE

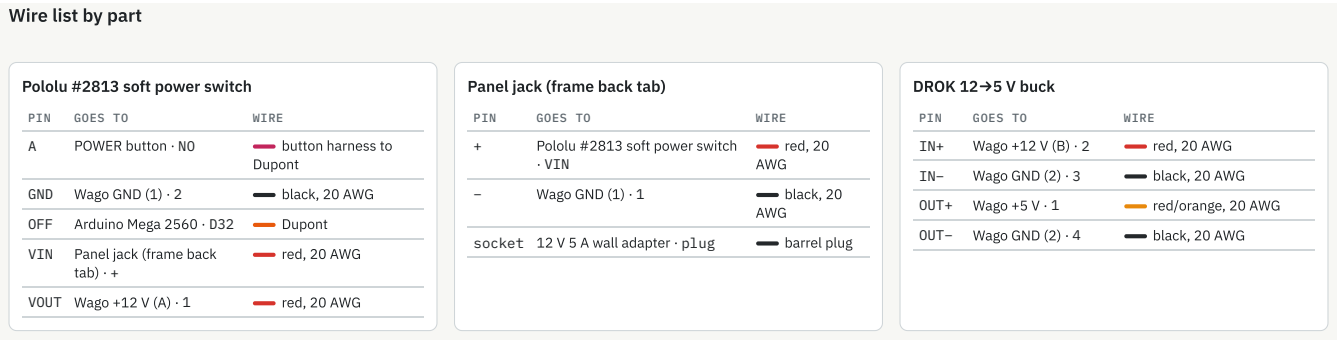
[picture p37: page 5]
POWER button · NO; button harness to; Dupont; GND Wago GND (1) · 2; black, 20 AWG; OFF Arduino Mega 2560 · D32; tab) · +; red, 20 AWG; VOUT Wago +12 V (A) · 1; PIN; GOES TO; WIRE; Pololu #2813 soft power switch; · VIN; red, 20; AWG; Wago GND (1) · 1; black, 20; socket 12 V 5 A wall adapter · plug; barrel plug; DROK 12→5 V buck; Wago +12 V (B) · 2; Wago GND (2) · 3; OUT+ Wago +5 V · 1; red/orange, 20 AWG; OUT− Wago GND (2) · 4

Pololu #2813 soft power switch

Panel jack (frame back tab)

VIN Panel jack (frame back

PIN GOES TO | WIRE

## 1 Y−

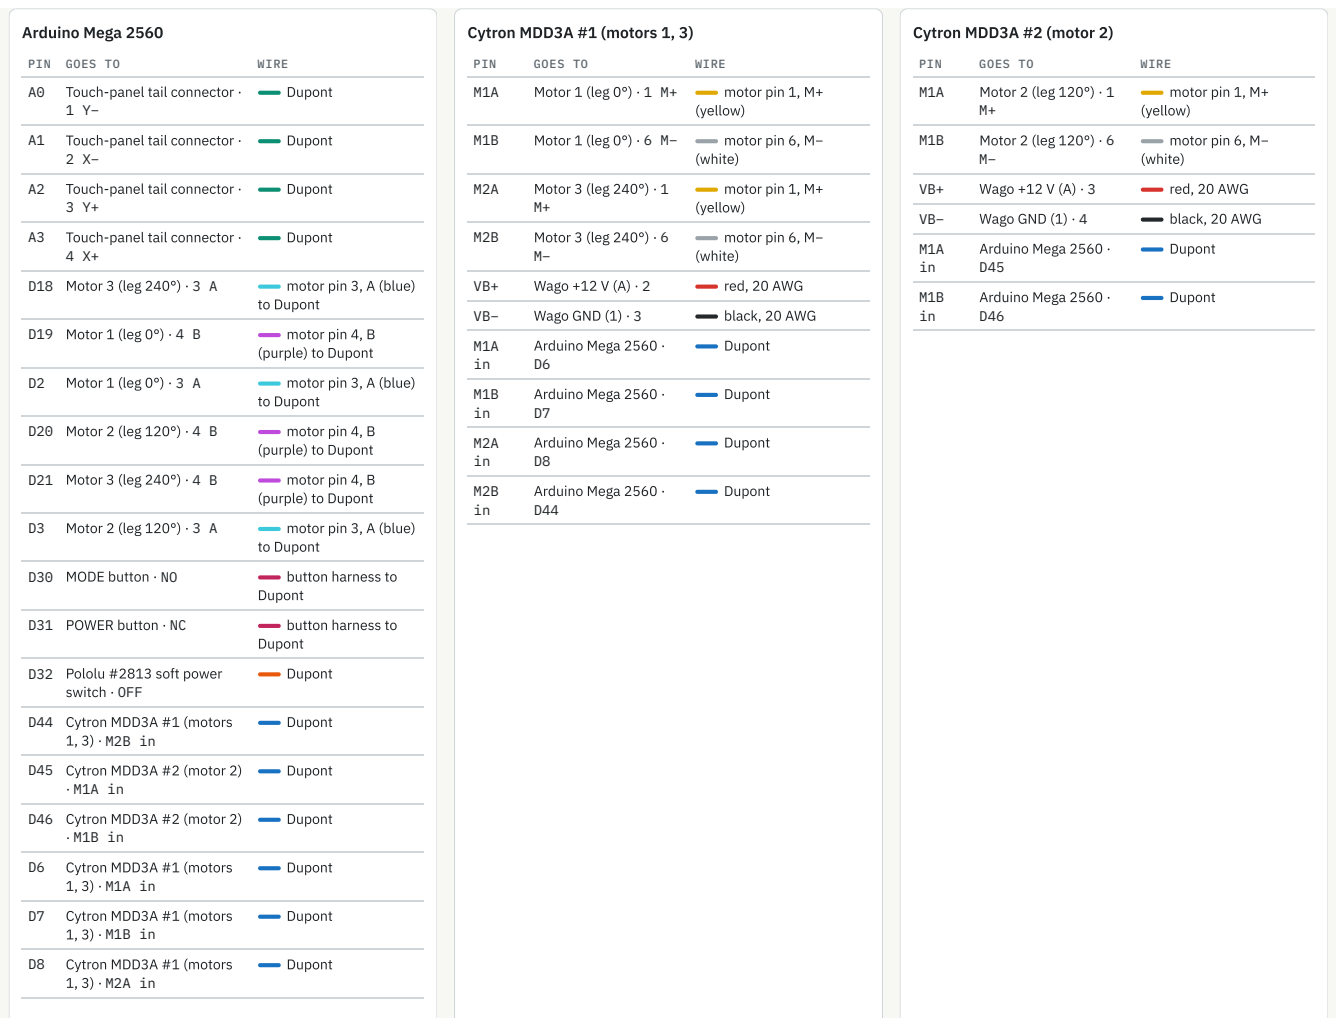
[picture p38: page 6]

A0 Touch-panel tail connector ·

A1 Touch-panel tail connector ·

A2 Touch-panel tail connector ·

A3 Touch-panel tail connector ·

PIN GOES TO | WIRE
PIN | GOES TO | WIRE

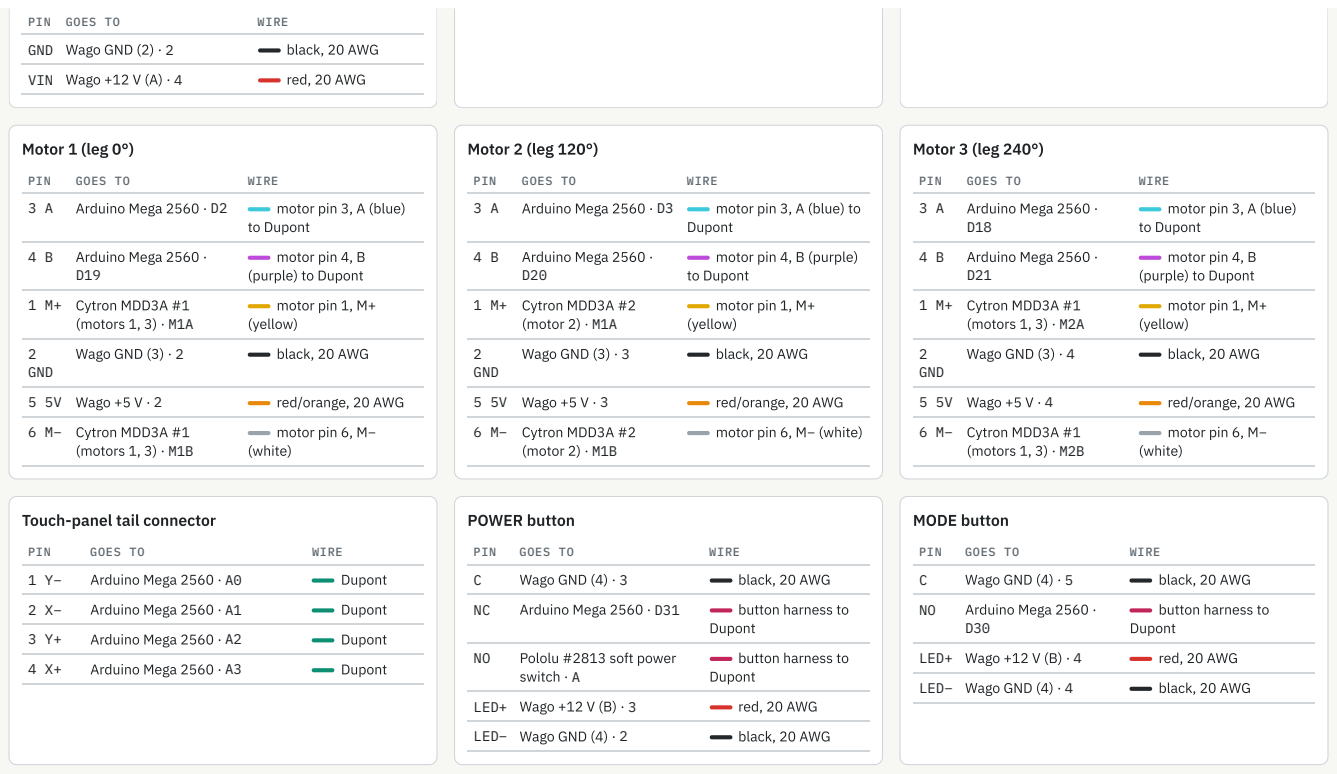
[picture p39: page 7]

Touch-panel tail connector

PIN GOES TO | WIRE
2) · VB+

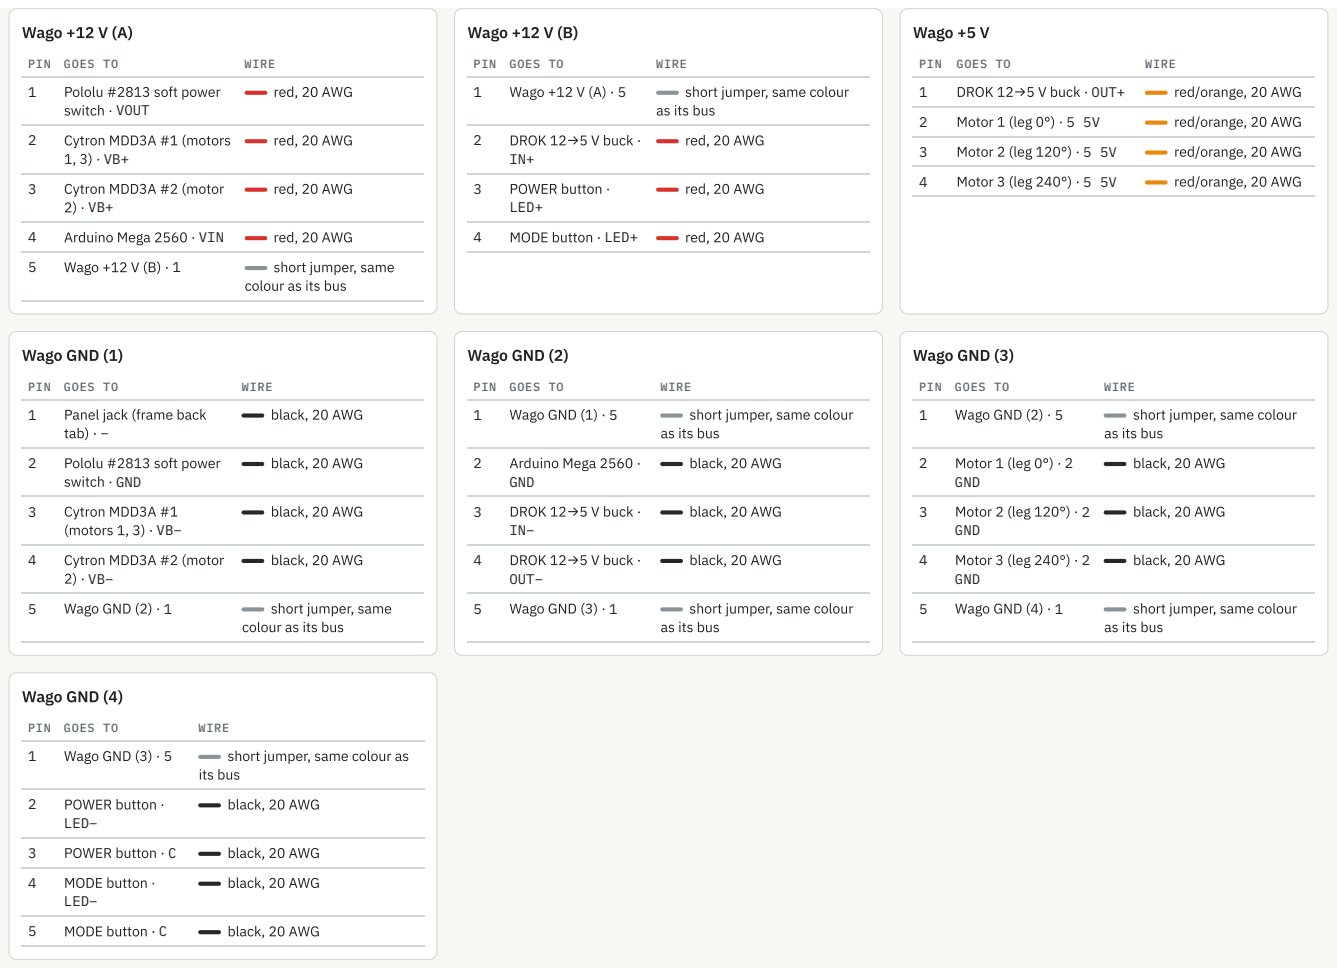
[picture p40: page 8]
Wago +12 V (A); switch · VOUT; red, 20 AWG; 2 Cytron MDD3A #1 (motors; 3 Cytron MDD3A #2 (motor; Arduino Mega 2560 · VIN; Wago +12 V (B) · 1; short jumper, same; Wago +12 V (B); PIN GOES TO; WIRE; Wago +12 V (A) · 5; short jumper, same colour; 2 DROK 12→5 V buck · IN+; 3 POWER button · LED+; MODE button · LED+; Wago +5 V; DROK 12→5 V buck · OUT+; red/orange, 20 AWG; Motor 1 (leg 0°) · 5 5V; Motor 2 (leg 120°) · 5 5V; Motor 3 (leg 240°) · 5 5V; Wago GND (1); tab) · −; black, 20 AWG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

1 Pololu #2813 soft power

as its bus

colour as its bus

1 Panel jack (frame back

2 Pololu #2813 soft power
