mattgardner70/best-ball-balancer/images/assembly/wiring_top_poster.png

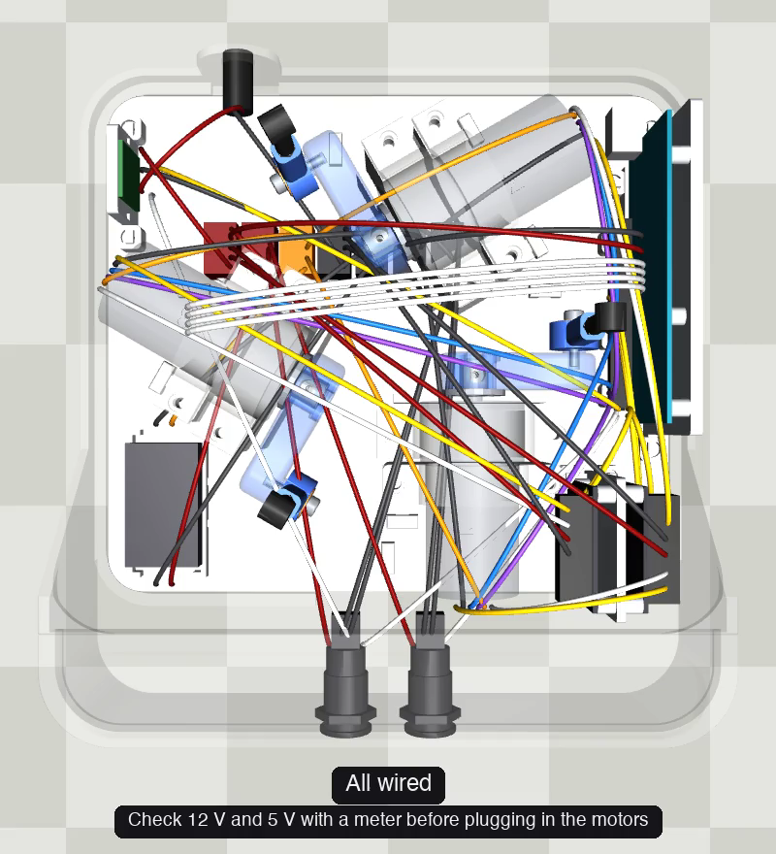
images/assembly/wiring_top_poster.png
