mattgardner70/best-ball-balancer/code/tools/paths/circle_paths_test2.csv

angle_deg | target_path_x_mm | target_path_y_mm | goal_circle_x_mm | goal_circle_y_mm | previous_target_x_mm | previous_target_y_mm | radial_correction_mm
0 | 56.110 | 0.000 | 45.00 | 0.00 | 56.61 | 0.00 | -0.500
1 | 56.130 | 0.980 | 44.99 | 0.79 | 56.61 | 0.99 | -0.480
2 | 56.135 | 1.960 | 44.97 | 1.57 | 56.60 | 1.98 | -0.465
3 | 56.125 | 2.941 | 44.94 | 2.36 | 56.58 | 2.97 | -0.456
4 | 56.089 | 3.922 | 44.89 | 3.14 | 56.54 | 3.95 | -0.452
5 | 56.040 | 4.903 | 44.83 | 3.92 | 56.49 | 4.94 | -0.452
6 | 55.976 | 5.883 | 44.75 | 4.70 | 56.43 | 5.93 | -0.456
7 | 55.889 | 6.862 | 44.66 | 5.48 | 56.35 | 6.92 | -0.464
8 | 55.779 | 7.839 | 44.56 | 6.26 | 56.25 | 7.91 | -0.476
9 | 55.654 | 8.815 | 44.45 | 7.04 | 56.14 | 8.89 | -0.492
10 | 55.528 | 9.791 | 44.32 | 7.81 | 56.03 | 9.88 | -0.510
11 | 55.368 | 10.763 | 44.17 | 8.59 | 55.89 | 10.86 | -0.531
12 | 55.199 | 11.733 | 44.02 | 9.36 | 55.74 | 11.85 | -0.554
13 | 55.006 | 12.699 | 43.85 | 10.12 | 55.57 | 12.83 | -0.579
14 | 54.802 | 13.664 | 43.66 | 10.89 | 55.39 | 13.81 | -0.606
15 | 54.587 | 14.627 | 43.47 | 11.65 | 55.20 | 14.79 | -0.634
16 | 54.341 | 15.582 | 43.26 | 12.40 | 54.98 | 15.76 | -0.663
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
