mattgardner70/best-ball-balancer/code/tools/paths/figure8_target_test8_revert_test5.csv

phase_deg | target_path_x_mm | target_path_y_mm | goal_x_mm | goal_y_mm | previous_target_x_mm | previous_target_y_mm | delta_x_mm | delta_y_mm
0 | 5.0 | -7.0 | 0.0 | 0.0 | 5.0 | -7.0 | 0.0 | 0.0
1 | 6.011 | -5.487 | 0.625 | 0.66 | 6.011 | -5.485 | -0.0 | -0.002
2 | 7.015 | -3.964 | 1.248 | 1.322 | 7.015 | -3.954 | -0.0 | -0.01
3 | 8.032 | -2.433 | 1.869 | 1.986 | 8.032 | -2.411 | -0.0 | -0.022
4 | 9.056 | -0.908 | 2.489 | 2.652 | 9.056 | -0.869 | -0.0 | -0.039
5 | 10.073 | 0.627 | 3.107 | 3.318 | 10.073 | 0.687 | -0.0 | -0.06
6 | 11.093 | 2.155 | 3.726 | 3.984 | 11.093 | 2.241 | -0.0 | -0.086
7 | 12.121 | 3.674 | 4.345 | 4.65 | 12.121 | 3.791 | -0.0 | -0.117
8 | 13.149 | 5.186 | 4.965 | 5.314 | 13.15 | 5.338 | -0.001 | -0.152
9 | 14.182 | 6.689 | 5.587 | 5.978 | 14.183 | 6.88 | -0.001 | -0.191
10 | 15.209 | 8.169 | 6.211 | 6.639 | 15.211 | 8.403 | -0.002 | -0.234
11 | 16.24 | 9.637 | 6.838 | 7.297 | 16.243 | 9.918 | -0.003 | -0.281
12 | 17.266 | 11.091 | 7.468 | 7.953 | 17.27 | 11.422 | -0.004 | -0.331
13 | 18.304 | 12.507 | 8.102 | 8.604 | 18.309 | 12.891 | -0.005 | -0.384
14 | 19.335 | 13.909 | 8.74 | 9.252 | 19.342 | 14.35 | -0.007 | -0.441
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
