mattgardner70/best-ball-balancer/(commit log)

2026-10-20 Best Ball Balancer: CAD, printable parts, firmware, simulation, BOM, wiring and assembly guide
    [arm.stl, ball_socket.stl, ball_stud.stl, base_plate.stl, bushing.stl, button.stl, button_ring.stl, frame.stl]
2026-10-20 CAD: README on CadQuery, why code-based CAD, and setup
2026-10-20 Base v3: bolt-on holders for the Mega, motor drivers and power switch; spring-preloaded motor straps with wrench room; motor numbers; MDD3A heatsinks; docs and renders updated
    [base_plate.stl, driver_mount.stl, mega_mount.stl, strap_gearbox.stl, strap_motor.stl, switch_mount.stl]
2026-10-20 Plate in two quick prints: rim + insert (glass seat with the joint nubs and ribbon clips underneath); docs and renders updated
    [plate_holder_base.stl, plate_holder_rim.stl, plate_insert.stl, plate_rim.stl]
2026-10-20 Assembly animations for every stage, a wire-by-wire wiring video, and a wiring guide
2026-10-20 Docs: drop the aside about the dead driver
2026-10-20 Wiring video: square framing, bus-coloured wires (12 V dark red, 5 V orange, ground grey, encoders blue/purple, signals yellow/white), opens unwired, 5 s per connection, under 10 MB
2026-10-20 README: current plate and holder design; link the wiring video from the time estimate
2026-10-20 Remove the wiring diagram's HTML and generator; the video reads its own copy of the connection list
2026-10-20 Use the uploaded wiring video everywhere; fix its length and timing in the text
2026-10-20 BOM: motor listing (Sileduove JGB37-520, 12 V, 333 rpm, encoder)
2026-10-20 BOM: heatsink price ($6.99); total about $236
2026-10-20 BOM: motor price ($14.40 each); total about $279
2026-10-20 BOM: price-each and line-total columns
2026-10-20 BOM: MDD3A price ($9.30 each); total about $297
2026-10-20 MDD3As mount with M3 (self-tapping): M2.5 screws dropped from the BOM; driver holder pilots 2.5 mm
    [driver_mount.stl]
2026-10-20 BOM: complete which-fastener-goes-where table, in build order
2026-10-20 BOM: fastener table in build order
2026-10-20 BOM: fix the printed-parts table divider
2026-10-20 README: PID tuning section
2026-10-20 CAD README: making changes with an AI assistant
2026-10-21 Holders: clear screw holes, driver tabs between the standoffs, Mega and switch mounts print flat on their backs; screw holders down before mounting boards
    [base_plate.stl, driver_mount.stl, mega_mount.stl, switch_mount.stl]
2026-10-21 Mega mount: the board ledge is a solid block back to the wall (it was a floating island)
    [mega_mount.stl]
2026-10-21 Mega mount: four standoffs (top-edge inserts would break out of the wall); docs: 34 inserts, 4 Mega screws
    [mega_mount.stl]
2026-10-22 Lattice shell: no ribbon-cable hole; arm openings 50% bigger (48 x 33 mm)
    [lattice_shell.stl, liner.stl]
2026-10-22 Lattice shell v2: prints top-down without supports (pointed ceilings, 60 deg max overhang); v1 kept
    [lattice_shell.stl, lattice_shell_v1.stl, lattice_shell_v2.stl]
2026-10-22 Lattice shell v2: no floating sections (openings stop short of the wall notches)
    [lattice_shell_v2.stl]
2026-10-23 Arm: bolt pattern turned 45 deg so both set screws face the access holes; assembly note
    [arm.stl, hub.stl]
2026-10-24 Driver mount fits the printed base (tabs at the wall ends), top posts only with heat-set inserts; docs: 38 inserts, M3 x 6 for the MDD3As
    [base_plate.stl, driver_mount.stl]
2026-10-24 Holders verified against the boards and the printed base: Mega holes no longer mirrored (checked against the Mega footprint), 7 mm insert standoffs; Mega end and switch tab screws on the printed pads
    [base_plate.stl, driver_mount.stl, mega_mount.stl, switch_mount.stl]
2026-10-24 Holders: no collisions with the base, tabs centred on the pads, flat backs; CAD/check_holders.py fit test
    [driver_mount.stl, mega_mount.stl, switch_mount.stl]
2026-11-04 Finished build: tuning guide and tools, tuned paths, buttons, USB cable and sabot, Mega upside down; wiring guide matches the firmware
    - tuning.md: set the centre, tune the PID and tune the paths over the console, with the live
    top-down visualizer (code/tools/viz.py) and the path tool (shape.py). The ball never follows a path
    exactly; hand-tuned paths are the easy, quiet fix (before/after pictures).
    - Firmware: per-pin logging and an encoder flood guard; MODE button steps the pattern; POWER button
    parks the arms then switches the power off (D32); typed console commands with EEPROM-saved settings;
    park before flashing; tuned circle and figure-8 as defaults.
    - Wiring guide (PDF, wire l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
    [circle_paths_test2.csv, figure8_ideal_goal_path.csv, figure8_target_test8_revert_test5.csv, frame.stl, mega_mount.stl, plate_insert.stl, usb_sabot.stl]
